shreytheshreyas/AI-Accelerated-Augmented-Reality-Laser-Tag-Game/Hardware-Sensors/Hardware-Sensors.md

# Documentation for Hardware-Sensors
## Setup 
For Gun and Vest, uncomment the respective lines defining the variable `command` in the following manner:
1. Player 1's shots should have the IR Command `X` so Player 2's Vest should receive the same command. 
2. Player 2's shots have command `Y` to be received by Player 1's Vest.

Upload the respective code to the devices of both players using Arduino
