shreytheshreyas/AI-Accelerated-Augmented-Reality-Laser-Tag-Game/(commit log)

2023-02-07 First Version of Internal Comms relay node codebase
2023-02-07 Coded simple implementation of transmission between central device and peripherals
2023-02-07 handshake implementation done for relay node
2023-02-13 add software mlp model and saved weights and biases
    [processed_filtered_test_dataset.csv, processed_filtered_train_dataset.csv]
2023-02-13 change folder structure
    [processed_filtered_test_dataset.csv, processed_filtered_train_dataset.csv]
2023-02-14 Add inidvidual tests
    [groupB13_cli_logs.csv, groupB13_logs.csv]
2023-02-16 Complete pipeline
    [groupB13_cli_logs.csv]
2023-02-16 Sensor Code Version-1 Implementation
2023-02-16 Made importat changes to relay node code
2023-02-19 Working implementation of wireless communication of all the sensors
2023-02-22 Update IMU
2023-03-03 Data Collection
    [reload_data.csv, shield_data.csv]
2023-03-06 Update Game Engine
    [groupB13_cli_logs.csv]
2023-03-06 Implemented code to successfully connect to the server
    [reload_data.csv]
2023-03-08 modified gun and vest code for wireless communication of data
2023-03-12 changes made for the IMU and the code to transmit data to the
2023-03-13 add files for data preprocess and fpga code
    [dataset1.csv, dataset2.csv, processed_filtered_test_dataset.csv, processed_filtered_train_dataset.csv]
2023-03-13 add software model code and training datasets
    [test_data.csv, train_data.csv]
2023-03-24 Update reset for components
    [gun_code.ino]
2023-03-29 Lower latency
    [reload_data.csv]
2023-04-16 Clean up External Comms folder
    [groupB13_cli_logs.csv, groupB13_logs.csv]
2023-04-16 add software model and change hls code
    [test_data.csv, train_data.csv]
2023-04-16 add left glove hls code
    [dataset1.csv, dataset2.csv]
2023-04-16 add fpga files and changed readme
    [processed_filtered_test_dataset.csv, processed_filtered_train_dataset.csv]
2024-12-29 Added section for harware sensors\
